SinaRashidizade/Basic-Robotic/Solid files/Mixture(Dynamic)/Assem3.SLDASM

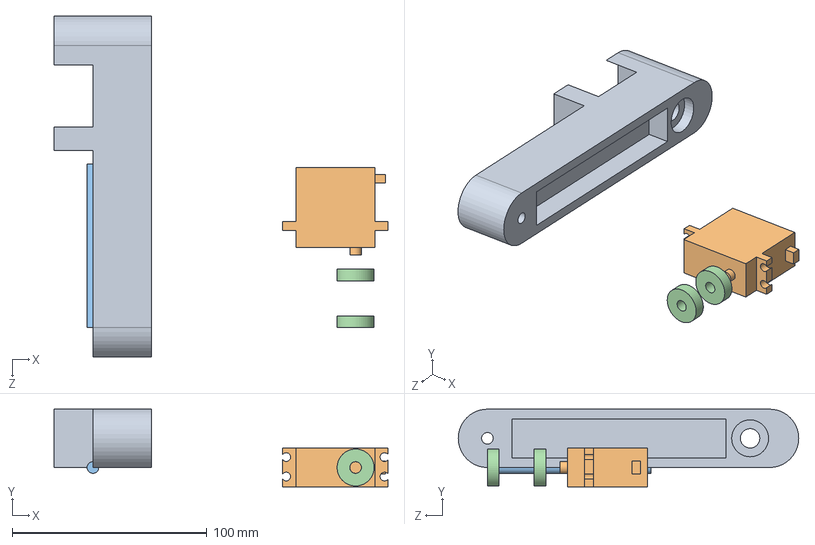
[picture p17: CAD file, 2022-08-15]
Solid files/Mixture(Dynamic)/Assem3.SLDASM
171.6 x 39.9 x 175.0 mm
link2
motor
shaft2
Bearing x 2
