SinaRashidizade/Basic-Robotic/Solid files/Mixture(Dynamic)/Assem4.SLDASM

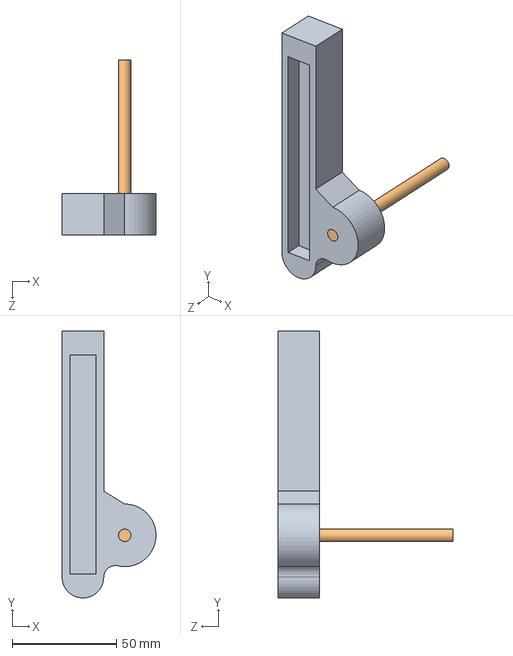
[picture p18: CAD file, 2022-08-15]
Solid files/Mixture(Dynamic)/Assem4.SLDASM
45.0 x 127.8 x 84.0 mm
Link3
shaft2
