SinaRashidizade/Basic-Robotic/Solid files/Robot parts/Assem.SLDASM

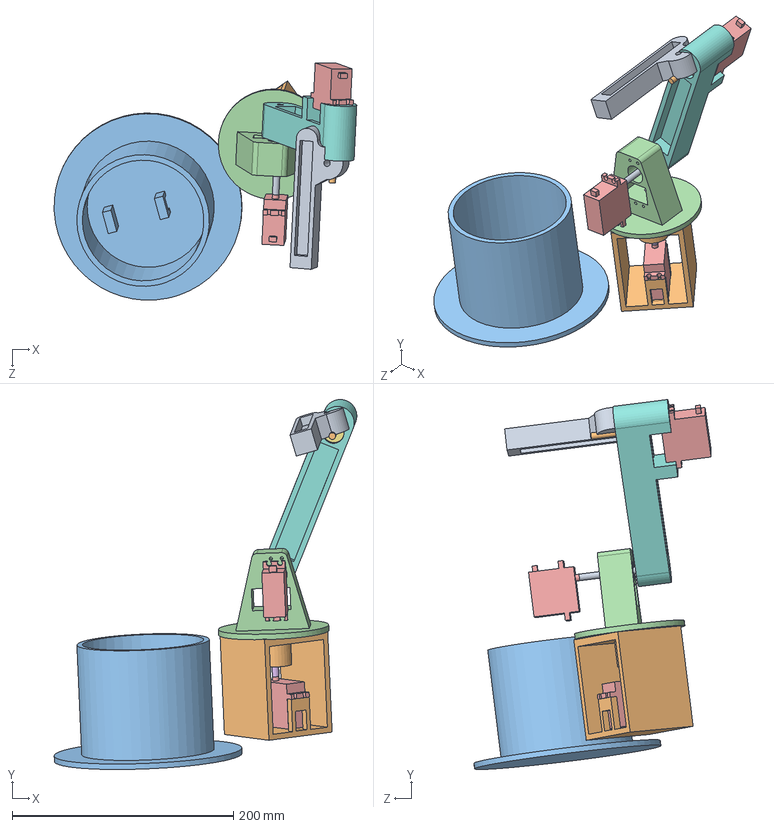
[picture p19: CAD file, 2022-08-15]
Solid files/Robot parts/Assem.SLDASM
273.7 x 334.7 x 214.6 mm
motor x 3
shaft
Hosing
Bearing x 6
link2
Link3
shaft2
shaft3
