SinaRashidizade/Basic-Robotic/Solid files/Mixture(Dynamic)/Assem2.SLDASM

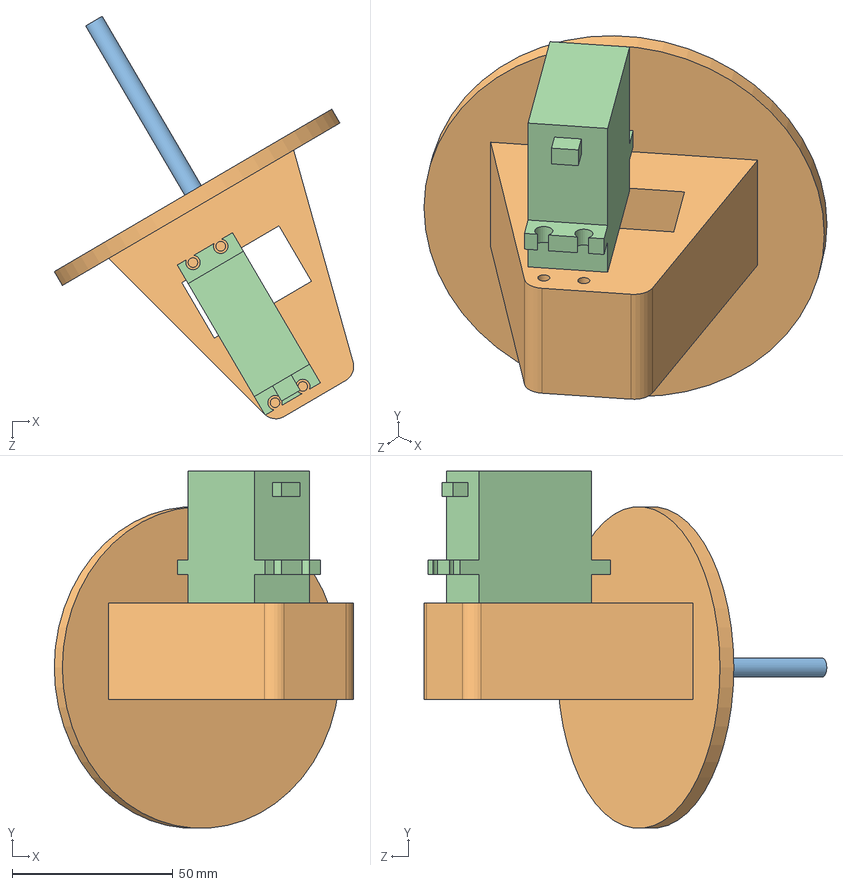
[picture p20: CAD file, 2022-08-15]
Solid files/Mixture(Dynamic)/Assem2.SLDASM
93.1 x 111.0 x 125.2 mm
Bearing x 2
shaft2
motor
