SinaRashidizade/Basic-Robotic/Solid files/Mixture(Dynamic)/motor.SLDPRT

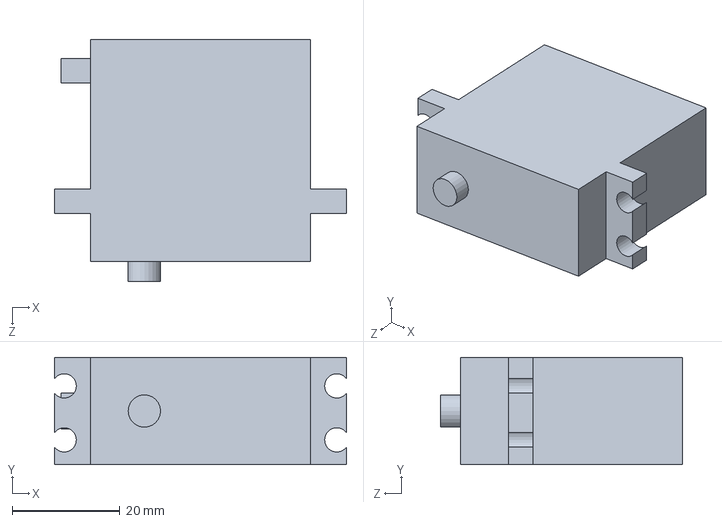
[picture p21: CAD file, 2022-08-15]
Solid files/Mixture(Dynamic)/motor.SLDPRT
54.1 x 19.9 x 44.8 mm
