SinaRashidizade/Basic-Robotic/Solid files/Robot parts/shaft.SLDPRT

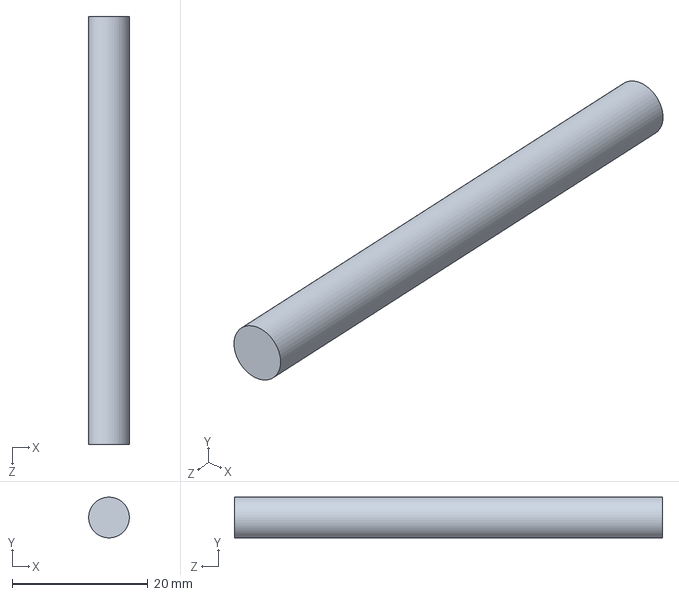
[picture p22: CAD file, 2022-08-15]
Solid files/Robot parts/shaft.SLDPRT
6.00 x 6.00 x 63.0 mm
