SinaRashidizade/Basic-Robotic/Solid files/Mixture(Dynamic)/shaft2.SLDPRT

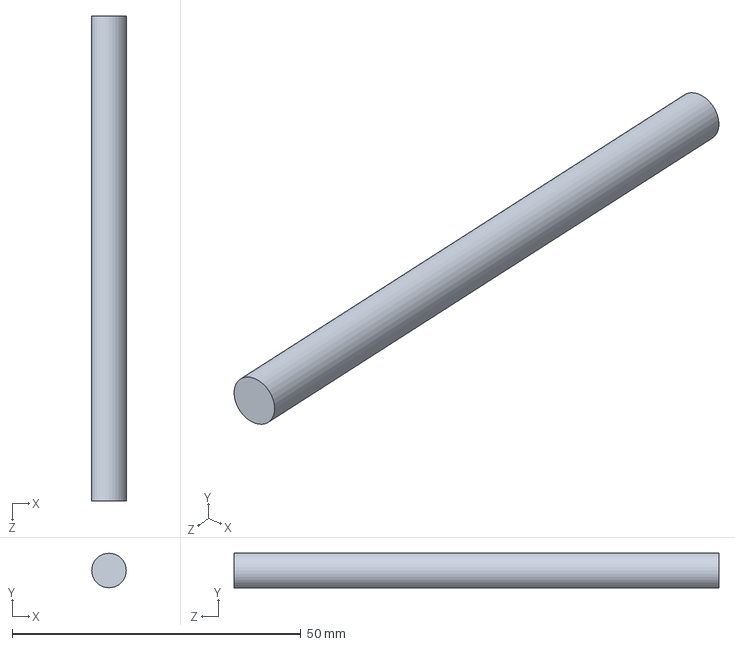
[picture p23: CAD file, 2022-08-15]
Solid files/Mixture(Dynamic)/shaft2.SLDPRT
6.00 x 6.00 x 84.0 mm
