SinaRashidizade/Basic-Robotic/Solid files/Robot parts/Hosing.SLDPRT

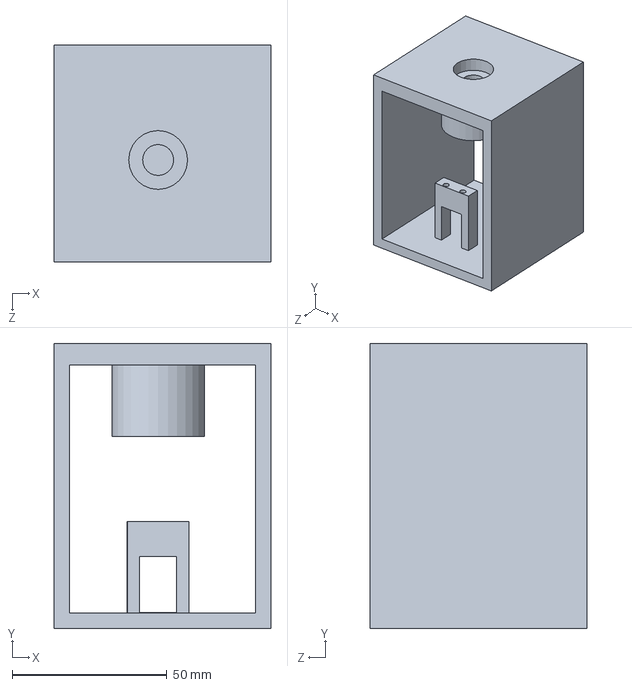
[picture p24: CAD file, 2022-08-15]
Solid files/Robot parts/Hosing.SLDPRT
70.0 x 92.0 x 70.0 mm
