SinaRashidizade/Basic-Robotic/Solid files/Mixture(Dynamic)/Bearing.SLDPRT

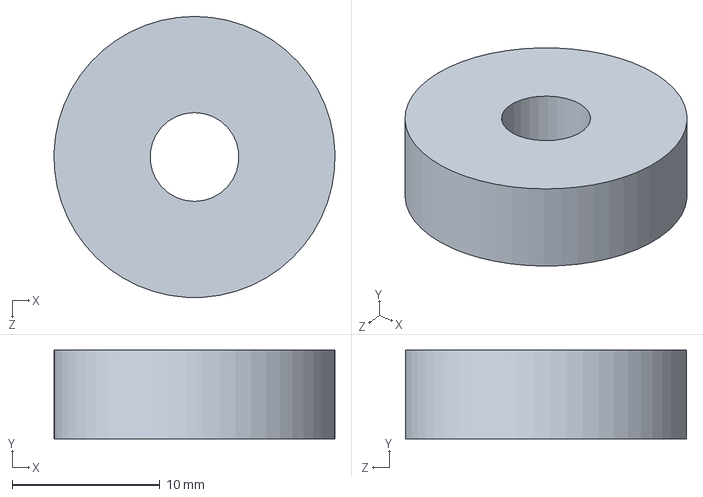
[picture p25: CAD file, 2022-08-15]
Solid files/Mixture(Dynamic)/Bearing.SLDPRT
19.0 x 6.00 x 19.0 mm
