SinaRashidizade/Basic-Robotic/Solid files/Robot parts/shaft2.SLDPRT

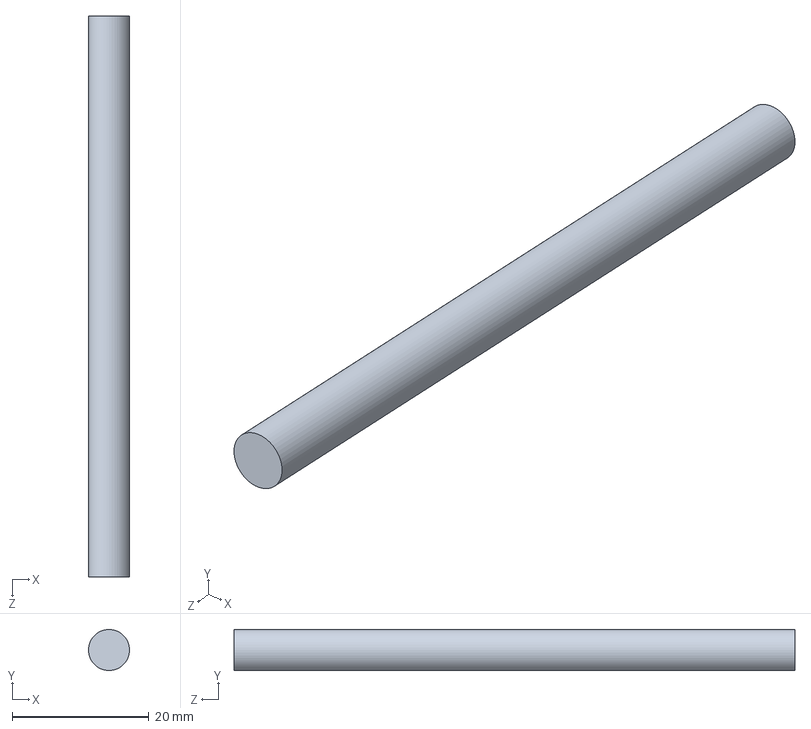
[picture p26: CAD file, 2022-08-15]
Solid files/Robot parts/shaft2.SLDPRT
6.00 x 6.00 x 82.0 mm
