SinaRashidizade/Basic-Robotic/Solid files/Mixture(Dynamic)/Link3.SLDPRT

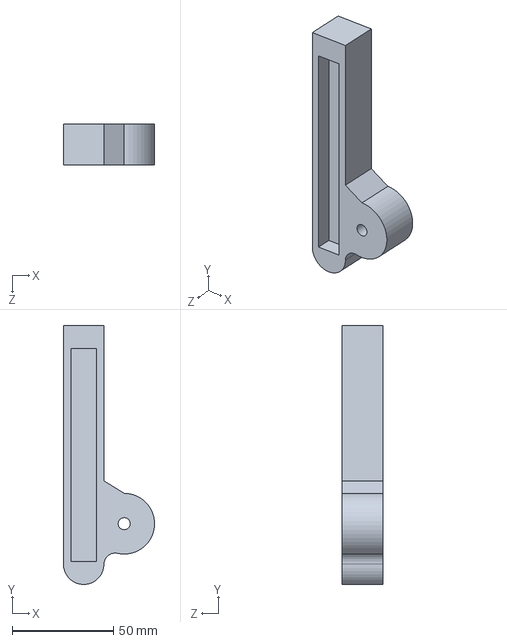
[picture p27: CAD file, 2022-08-15]
Solid files/Mixture(Dynamic)/Link3.SLDPRT
45.0 x 127.8 x 20.0 mm
