SinaRashidizade/Basic-Robotic/Solid files/Robot parts/link2.SLDPRT

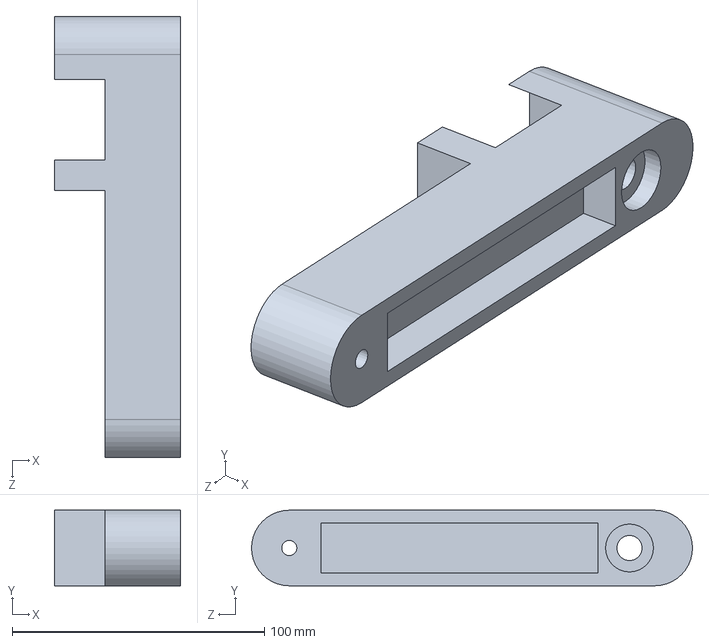
[picture p28: CAD file, 2022-08-15]
Solid files/Robot parts/link2.SLDPRT
50.0 x 30.0 x 175.0 mm
