SinaRashidizade/Basic-Robotic/Solid files/Mixture(Dynamic)/shaft3.SLDPRT

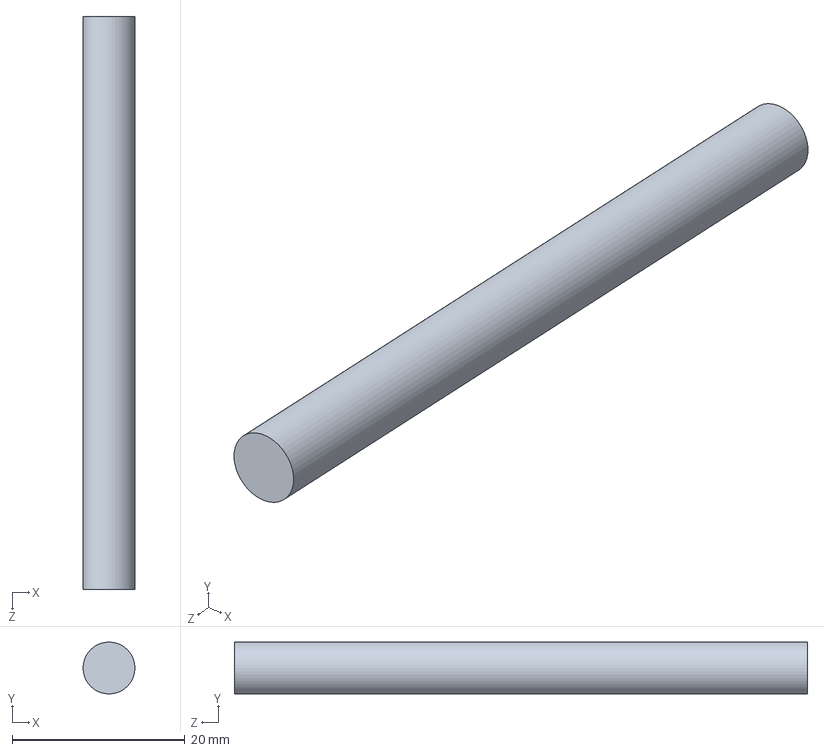
[picture p29: CAD file, 2022-08-15]
Solid files/Mixture(Dynamic)/shaft3.SLDPRT
6.00 x 6.00 x 66.3 mm
