SinaRashidizade/Basic-Robotic/Solid files/Mixture(Dynamic)/Part2_2.SLDPRT

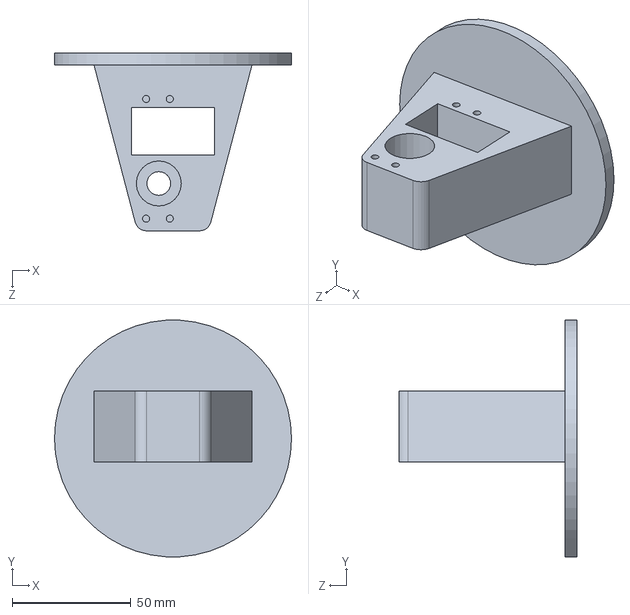
[picture p30: CAD file, 2022-08-15]
Solid files/Mixture(Dynamic)/Part2_2.SLDPRT
100.0 x 99.8 x 75.0 mm
