SinaRashidizade/Basic-Robotic/(list of files, cad)

Other CAD files:
Solid files/Robot parts/motor.SLDPRT
Solid files/Robot parts/Bearing.SLDPRT
Solid files/Mixture(Dynamic)/link2.SLDPRT
Solid files/Robot parts/Part2_2.SLDPRT
Solid files/Robot parts/Link3.SLDPRT
